drgdlr09/E-Paper-CheckList/BOM.csv

Item | Qty | Supplier | Cost/item | Total Cost | link
3.3V LiPo Battery | 1 | AliExpress | $1.06 | $1.06 | https://www.aliexpress.us/item/3256812728637526.html?curPageLogUid=hmPLZJuXs5F1
ESP32-S3 | 1 | AliExpress | $6.83 | $6.83 | https://www.aliexpress.us/item/3256806801590776.html?mp=1
2.9" E-Paper Screen | 1 | AliExpress | $14.22 | $14.22 | https://www.aliexpress.us/item/3256813257005880.html?mp=1
PCB | 1 | JLCPCB | $1.75 | $1.75 | https://jlcpcb.com/
Estimated total shipping | 1 |  |  | $6.56
