drgdlr09/E-Paper-CheckList/bom.csv

Designator | Footprint | Quantity | Value | LCSC Part #
C1 | C_Disc_D3.0mm_W1.6mm_P2.50mm | 1 | 100nF
J1 | PinHeader_1x08_P2.54mm_Vertical | 1 | E-paper
J2 | PinHeader_1x01_P2.54mm_Vertical | 1 | BAT+IN
J3 | PinHeader_1x01_P2.54mm_Vertical | 1 | BAT+OUT
R1, R2 | R_Axial_DIN0207_L6.3mm_D2.5mm_P10.16mm_Horizontal | 2 | 100k
R3, R4, R5 | R_Axial_DIN0207_L6.3mm_D2.5mm_P10.16mm_Horizontal | 3 | 10k
SW1 | PinHeader_1x03_P2.54mm_Vertical | 1 | SS12D00
SW2 | SW_PUSH_6mm | 1 | UP
SW3 | SW_PUSH_6mm | 1 | OK
SW4 | SW_PUSH_6mm | 1 | DOWN
U1 | XIAO ESP32-S3 | 1 | XIAO-ESP32-S3
