drgdlr09/E-Paper-CheckList/design/EpaperChecklist.kicad_pcb

## KiCad design design/EpaperChecklist.kicad_pcb (2026-11-09)

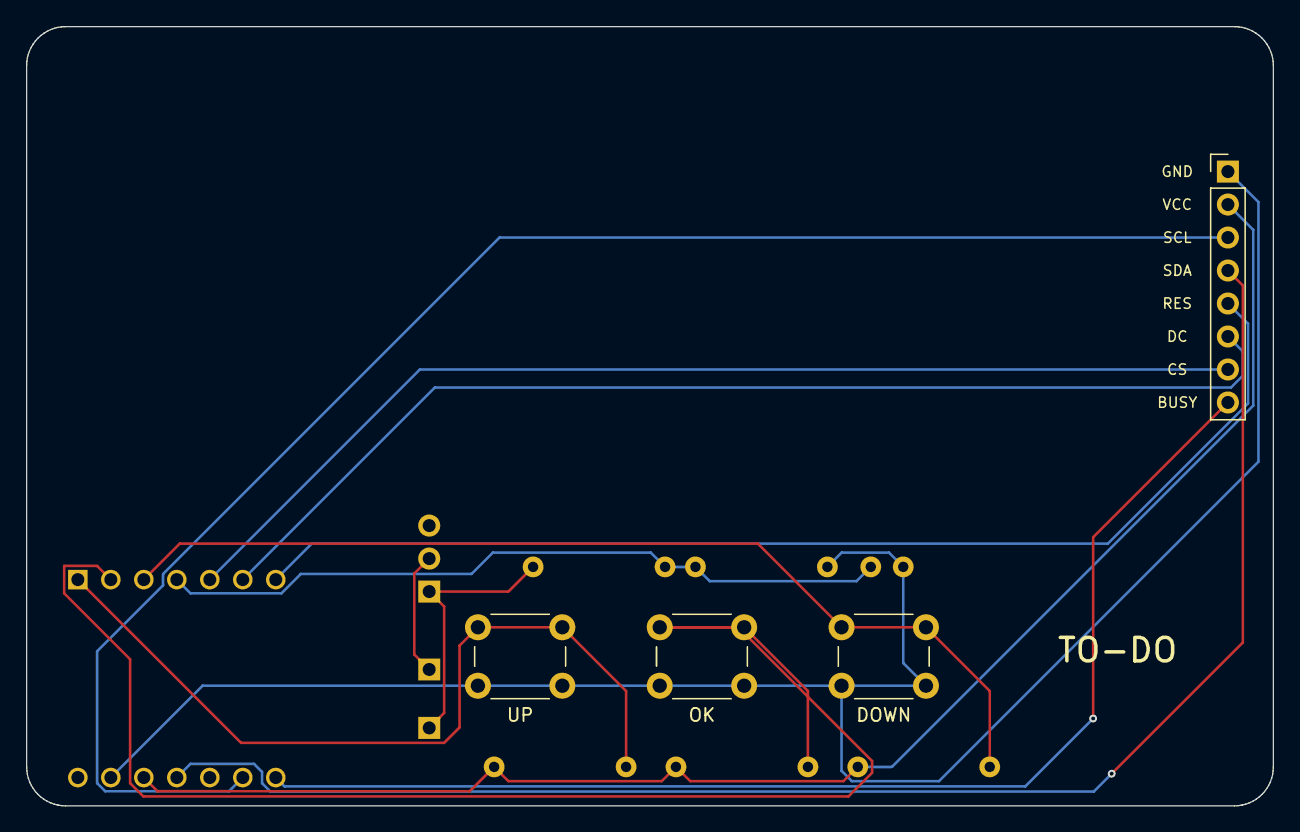
[picture p1: board EpaperChecklist.kicad_pcb from above]

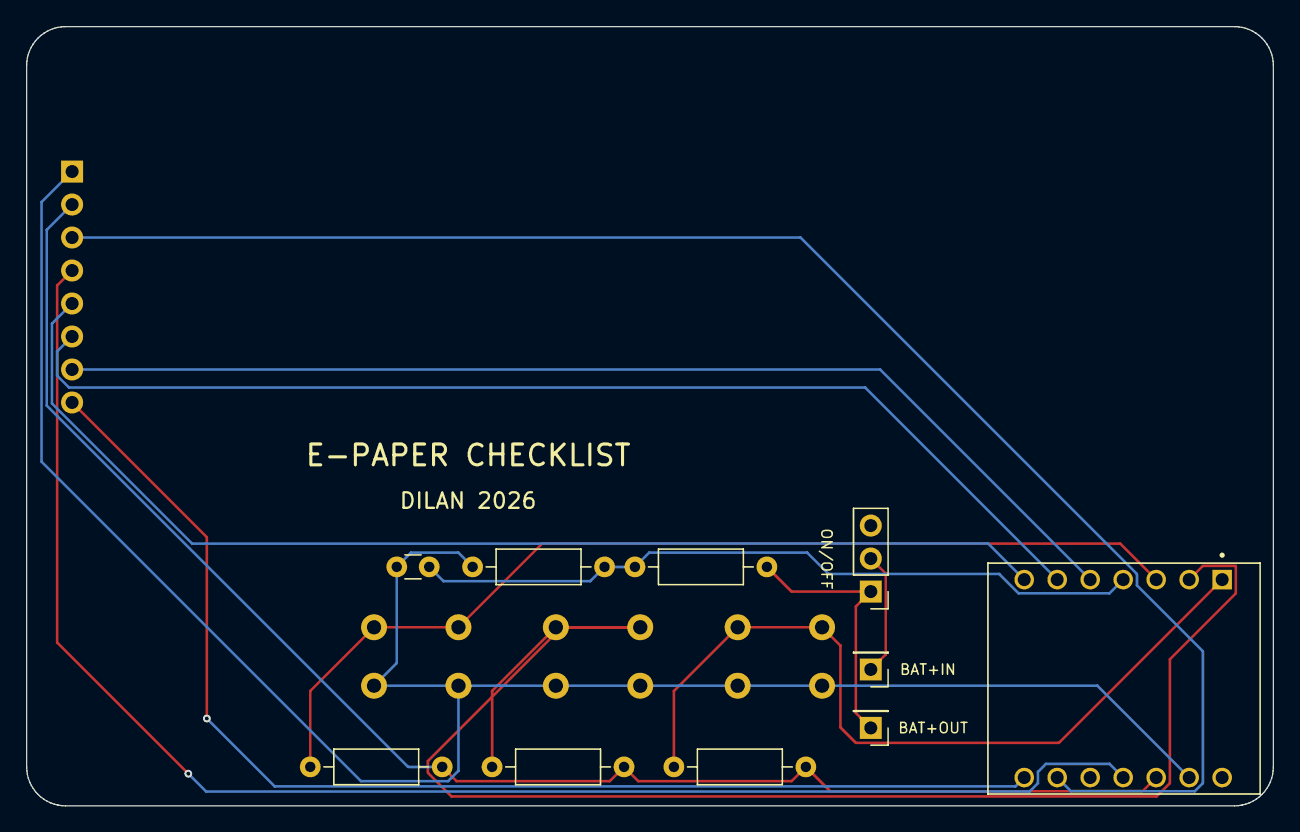
[picture p2: board EpaperChecklist.kicad_pcb from below]

Board: 2 copper layers, 96.0 x 60.0 mm, 14 parts (10 on the bottom side), 14 nets.

Parts:
C1: 100nF; C_Disc_D3.0mm_W1.6mm_P2.50mm
J1: E-paper; PinHeader_1x08_P2.54mm_Vertical
J2: BAT+IN; PinHeader_1x01_P2.54mm_Vertical
J3: BAT+OUT; PinHeader_1x01_P2.54mm_Vertical
R1, R2: 100k; R_Axial_DIN0207_L6.3mm_D2.5mm_P10.16mm_Horizontal
R3, R4, R5: 10k; R_Axial_DIN0207_L6.3mm_D2.5mm_P10.16mm_Horizontal
SW1: SS12D00; PinHeader_1x03_P2.54mm_Vertical
SW2: UP; SW_PUSH_6mm
SW3: OK; SW_PUSH_6mm
SW4: DOWN; SW_PUSH_6mm
U1: XIAO-ESP32-S3; XIAO ESP32-S3

Connections:
+3V3: J1.2, R3.1, R4.1, R5.1, U1.12
BAT_ADC: C1.1, R1.2, R2.1, U1.4
BAT_IN: J2.1, SW1.2
BAT_OUT: J3.1, R1.1, SW1.1
BTN_DOWN: R5.2, SW4.1, U1.3
BTN_OK: R4.2, SW3.1, U1.2
BTN_UP: R3.2, SW2.1, U1.1
EPD_BUSY: J1.8, U1.8
EPD_CS: J1.7, U1.5
EPD_DC: J1.6, U1.6
EPD_MOSI: J1.4, U1.11
EPD_RST: J1.5, U1.7
EPD_SCK: J1.3, U1.9
GND: C1.2, J1.1, R2.2, SW2.2, SW3.2, SW4.2, U1.13
