drgdlr09/E-Paper-CheckList/(commit log)

2026-11-08 Sync E-Paper Planner from Half Life
    [BOM.csv]
2026-11-08 Add Bill of Materials section to README
